eesraoncu/bitirme-ika-otonom/docs/Bitirme_Uygulama_Plani.docx

Bitirme Projesi Uygulama Planı

LLM Komutan, Gömülü Bekçi · Otonom İKA · Adım adım kurulum ve geliştirme

# 0. Bu Belge Nasıl Kullanılır

Belge baştan sona sırayla izlenmek için yazıldı. Her fazın sonunda yeşil bir “Bitti sayılır” kutusu var; o kutudaki koşul sağlanmadan bir sonraki faza geçme. Turuncu kutular sık yapılan hataları ve dikkat edilmesi gerekenleri gösterir. Gri zeminli satırlar terminale olduğu gibi yazılacak komutlardır.

Terminal, Ubuntu’da Ctrl + Alt + T ile açılır. Bir komutun başında sudo varsa sistem şifreni ister; yazarken ekranda karakter görünmez, bu normaldir.

Kod nerede yazılacak: Kodun tamamı Claude Code ile, kendi bilgisayarındaki proje klasöründe yazılır. Mimari kararlar, takıldığın yerler ve fazlar arası planlama için claude.ai sohbetini kullanmaya devam edebilirsin. Claude Code’un kurulumu Bölüm 3.10’da.

# 1. Sistemin Son Hâli

Kuracağın sistemde iki tür komut vardır ve ikisi de araca ulaşmadan önce STM32 kartından geçer:

- Görev komutu: LLM ajanının ürettiği üst seviye komut (“şu noktaya git”, “60 saniye bekle”, “hız sınırı 0,3 m/s”, “dur”). Kart onaylarsa Nav2’ye gider. Coğrafi sınır, tazelik, imza ve tutarlılık kuralları burada uygulanır.
- Hız komutu: Nav2’nin araca her saniye onlarca kez gönderdiği hareket komutu (cmd_vel: doğrusal ve açısal hız). Kart onaylarsa simülasyondaki İKA’ya gider. Fiziksel limitler ve kalp atışı kuralları burada uygulanır.

Bilgisayar ile kart arasında iki ayrı fiziksel hat vardır. Böylece ajan tarafı ile araç tarafı birbirine hiçbir yerde doğrudan dokunmaz:

Tablo 1. Fiziksel bağlantılar

Hat | Fiziksel bağlantı | Ne taşır
Ajan kanalı | PC USB → Nucleo’nun kendi USB portu (dahili sanal seri port) | PC’deki ajan ve Nav2’nin ürettiği komutlar karta gelir; ret gerekçeleri ajana döner.
CAN hattı | Kart üzerindeki FDCAN1 → CAN modülü → iki tel → CAN modülü → FDCAN2 | Onaylanan komutlar kartın “ajan tarafı” düğümünden “araç tarafı” düğümüne araç içi veri yolu gibi taşınır.
Araç kanalı | Kartın ikinci UART’ı → USB-TTL dönüştürücü → PC USB | Onaylı komutlar simülasyondaki İKA’ya gider; aracın telemetrisi (konum, hız) karta gelir.

Neden aynı kartta iki CAN düğümü? Gerçek bir araçta bekçi kartı ile motor sürücü kartı ayrı olur ve CAN ile konuşur. Elinde ikinci kart olmadığı için araç tarafındaki kartı, aynı Nucleo’nun ikinci CAN birimiyle taklit ediyorsun. Veri gerçekten tellerden geçtiği için CAN davranışı ve gecikmesi gerçektir. Bu kararı hocana da böyle anlatabilirsin.

# 2. Alışveriş Listesi

Parça | Adet | Not
STM32 NUCLEO-G474RE | 1 | Elinde var.
SN65HVD230 CAN alıcı-verici modülü | 2 | 3,3 V ile çalışan model olmalı. Üzerinde 120 Ω sonlandırma direnci (çoğunlukla “R2” ya da “120R” yazar) olup olmadığına bak; yoksa 2 adet 120 Ω direnç ekle.
USB-TTL dönüştürücü (CP2102 ya da CH340) | 1 | 3,3 V seviye seçilebilen bir model tercih et. Araç kanalı için.
Mantık analizörü (8 kanal, 24 MHz) | 1 | “Saleae uyumlu” diye satılır. Gecikme ölçümü ve hata ayıklama için. Önerilir.
Jumper kablo seti (erkek-dişi, dişi-dişi) | 1 set | Modülleri ve dönüştürücüyü karta bağlamak için.
Küçük breadboard | 1 | Modülleri sabitlemek için.
Veri destekli USB kablo | 2 | Biri Nucleo için (kartın portuna uyan tip), biri USB-TTL için gerekirse. Sadece şarj eden kablolar kartı tanımaz.

Robotistan, Direnc.net gibi elektronik mağazalarında hepsi bulunur. Tek siparişte almak kargo süresini kısaltır.

# 3. Kurulum (Faz 0 · Parçalar gelmeden yapılır)

Bu fazın amacı, kod yazmaya başlamadan önce her aracın çalıştığını tek tek doğrulamaktır. Her adımın sonunda bir doğrulama komutu var; onu çalıştırmadan sonraki adıma geçme.

Tablo 2. Kullanılacak yazılımlar

Yazılım | Ne işe yarar | Nereden
ROS 2 Humble | Robot yazılımının omurgası; tüm parçalar birbiriyle bunun üzerinden konuşur. | docs.ros.org/en/humble (Installation → Ubuntu deb packages)
Gazebo Fortress | İKA’nın ve ortamın simülasyonu. Humble’ın resmi eşi. | TurtleBot 4 kullanım kılavuzu ile birlikte kurulur
TurtleBot 4 simülatörü | Hazır İKA modeli: kamera (RGB-D), lidar ve sürüş sistemi hazır. | turtlebot.github.io/turtlebot4-user-manual
RTAB-Map | vSLAM: kamerayla haritayı çıkarır ve aracın konumunu bulur. | apt (ROS paketi)
Nav2 | Harita üzerinde rota planlar ve aracı hedefe sürer. | apt (ROS paketi)
STM32CubeIDE | STM32 kodu yazma, derleme, karta yükleme ve hata ayıklama. İçinde CubeMX (pin ve saat ayar aracı) da var. | st.com (ücretsiz myST hesabı ister)
PulseView | Mantık analizörünün bilgisayar programı. | apt
Ollama | LLM’i kendi bilgisayarında çalıştırmak için. | ollama.com
VS Code | Genel kod düzenleyici. | code.visualstudio.com
Git + GitHub | Sürüm kontrolü ve kodun yedeği. | apt + github.com
Claude Code | Kodun Claude ile birlikte yazılacağı ortam. | docs.claude.com/en/docs/claude-code/overview

## 3.1 Sistemi güncelle

ROS 2’nin resmi kurulum sayfası, Ubuntu 22.04’te ROS kurmadan önce sistemin güncellenmesini özellikle istiyor; aksi hâlde bazı kritik sistem paketleri silinebiliyor.

sudo apt update && sudo apt upgrade -y

Bittikten sonra bilgisayarı bir kez yeniden başlat.

## 3.2 Temel araçlar

sudo apt install -y git curl wget build-essential python3-pip python3-serial minicom

VS Code için code.visualstudio.com adresine git, “.deb” sürümünü indir, sonra indirilenler klasöründe şunu çalıştır (code_ ile başlayan dosya adını kendi dosyanla değiştir):

cd ~/İndirilenler # İngilizce sistemde: cd ~/Downloads

sudo apt install ./code_*.deb

Bitti sayılır: Terminalde git --version bir sürüm numarası yazıyor ve VS Code uygulama menüsünden açılıyor.

## 3.3 ROS 2 Humble

vSLAM çalışmasında ROS 2 kullandığın için kurulu olabilir. Önce kontrol et:

ls /opt/ros

Çıktıda humble görüyorsan bu adımın kurulum kısmını atla, sadece ortam ayarına ve teste bak. Görmüyorsan docs.ros.org/en/humble adresinde Installation → Ubuntu (deb packages) sayfasını aç ve oradaki “Setup Sources” bölümünü sayfadaki komutlarla harfi harfine uygula. Depo ekleme yöntemi zaman zaman değiştiği için bu kısmı buraya kopyalamadım; her zaman resmi sayfadaki güncel komutu kullan. Kaynak eklendikten sonra:

sudo apt update

sudo apt install -y ros-humble-desktop ros-dev-tools

Her yeni terminalde ROS’un otomatik tanınması için:

echo "source /opt/ros/humble/setup.bash" >> ~/.bashrc

source ~/.bashrc

Test: iki ayrı terminal aç. Birincisine konuşan, ikincisine dinleyen düğümü yaz:

ros2 run demo_nodes_cpp talker # 1. terminal

ros2 run demo_nodes_py listener # 2. terminal

Bitti sayılır: İkinci terminalde “I heard: Hello World” satırları akıyor. Durdurmak için Ctrl + C.

## 3.4 Gazebo Fortress ve TurtleBot 4 simülatörü

turtlebot.github.io/turtlebot4-user-manual adresinde Software → TurtleBot 4 Simulator sayfasını aç ve “humble” sekmesini seç. Kılavuz önce Ignition Fortress’in kurulmasını, ardından simülatör paketlerini istiyor. Fortress’i kılavuzdaki komutlarla kurduktan sonra:

sudo apt install -y ros-humble-turtlebot4-simulator ros-humble-irobot-create-nodes

Test:

ros2 launch turtlebot4_ignition_bringup turtlebot4_ignition.launch.py

Dikkat: İlk açılış, dünya modelleri internetten indirildiği için uzun sürebilir. Gazebo penceresi siyah kalırsa bu, bu simülatörde bilinen bir sorundur ve genellikle dünya dosyasının indirilememesinden kaynaklanır. Önce birkaç dakika bekle; düzelmezse sohbete gel, internet gerektirmeyen yerel bir dünya ayarlarız.

Bitti sayılır: Gazebo penceresinde TurtleBot 4 görünüyor ve başka bir terminalde ros2 topic list komutu kamera ve lidar konularını listeliyor.

## 3.5 RTAB-Map ve Nav2

sudo apt install -y ros-humble-rtabmap-ros ros-humble-navigation2 ros-humble-nav2-bringup ros-humble-teleop-twist-keyboard

Bitti sayılır: ros2 pkg list | grep -E "rtabmap|nav2" komutu paket isimlerini listeliyor.

## 3.6 STM32CubeIDE

1. st.com adresine git, arama kutusuna “STM32CubeIDE” yaz ve ürün sayfasını aç.
2. “Get Software” bölümünden “STM32CubeIDE Debian Linux Installer” satırındaki indirme düğmesine bas.
3. Sitede hesabın yoksa ücretsiz myST hesabı aç; e-postana gelen bağlantıdan indirmeyi tamamla.
4. İnen zip dosyasını indirilenler klasöründe aç (unzip dosya_adi.zip).
5. İçinden çıkan “.sh” uzantılı kurulum dosyasını çalıştır: chmod +x st-stm32cubeide_*.sh && sudo ./st-stm32cubeide_*.sh. Lisans sorularını kabul et; ST-LINK sürücülerinin (udev kuralları) kurulmasını da onayla.
6. Seri portlara şifresiz erişebilmek için kullanıcını dialout grubuna ekle: sudo usermod -aG dialout $USER. Bu ayar ancak oturumu kapatıp açınca geçerli olur.

Test (kartın çalıştığını görmek için LED yakıp söndürmek):

1. CubeIDE’yi aç, çalışma klasörü (workspace) olarak ev dizininde yeni bir klasör seç.
2. File → New → STM32 Project. “Board Selector” sekmesinde NUCLEO-G474RE’yi ara ve seç. Proje adına “deneme_led” yaz.
3. “Initialize all peripherals with their default Mode?” sorusuna Yes de. Kartın varsayılan ayarları gelir; LD2 adlı yeşil LED zaten tanımlı olur.
4. main.c içinde while (1) döngüsüne şu iki satırı ekle: HAL_GPIO_TogglePin(LD2_GPIO_Port, LD2_Pin); ve HAL_Delay(500);
5. Kartı USB ile bağla, üstteki yeşil ok (Run) düğmesine bas. İlk seferde ST-LINK yazılımını güncellemeyi önerebilir; kabul et.

Bitti sayılır: Karttaki yeşil LED saniyede bir yanıp sönüyor.

## 3.7 Seri port ve mantık analizörü araçları

sudo apt install -y pulseview sigrok-firmware-fx2lafw

Kartın seri portunu bulmak için kartı tak ve ls /dev/ttyACM* yaz; genellikle /dev/ttyACM0 çıkar. USB-TTL dönüştürücü ise /dev/ttyUSB0 olarak görünür.

## 3.8 Ollama (yerel LLM)

curl -fsSL https://ollama.com/install.sh | sh

nvidia-smi # ekran kartını ve belleğini gösterir

nvidia-smi bir tablo gösteriyorsa NVIDIA ekran kartın var demektir; tablodaki bellek miktarı hangi boyutta model çalıştırabileceğini belirler. Komut bulunamazsa ekran kartı yoktur ya da sürücüsü kurulu değildir. Hangi modeli kullanacağına Faz 4’te, bu bilgiye ve o günkü güncel seçeneklere göre birlikte karar vereceğiz; araç çağırmayı (tool calling) desteklemesi şart. Bilgisayar yetersiz kalırsa bir API kullanmak da mümkün.

## 3.9 Git ve GitHub

git config --global user.name "Esra Öncü"

git config --global user.email "github_e-postan"

github.com’da “bitirme-ika-bekci” adında özel (private) bir depo oluştur. Depoyu bilgisayarına Bölüm 4’teki klasör yapısını kurarken bağlayacağız.

## 3.10 Claude Code

Kurulum yöntemi zaman zaman güncellendiği için docs.claude.com/en/docs/claude-code/overview sayfasındaki güncel kurulum adımlarını izle ya da claude.ai/download adresinden masaüstü uygulamasını indir. Kurulumdan sonra proje klasöründe başlatıp claude.ai hesabınla giriş yapman yeterli.

Bitti sayılır: Bölüm 3’teki tüm yeşil kutular sağlandı. Bu noktada bilgisayarın projeye hazır.

# 4. Proje Klasör Yapısı

Temel kural: her sorumluluk kendi klasöründe durur ve bir kavram tek bir yerde gerçeklenir. Bir kuralı değiştirmek istediğinde tek bir klasöre bakman yeterli olmalı. Bir değişiklik birden fazla klasöre dokunmayı gerektiriyorsa tasarım yanlıştır.

bitirme-ika-bekci/

├── docs/ STATUS, DECISIONS, RULES, protocol

├── shared/protocol/ messages.yaml (mesajların TEK tanımı)

├── firmware/ STM32CubeIDE projesi

│ └── app/

│ ├── protocol/ çerçeve çözme, CRC

│ ├── auth/ HMAC imza, tekrar kontrolü

│ ├── rules/

│ │ ├── geofence/ coğrafi sınır

│ │ ├── limits/ hız, ivme, dönüş

│ │ ├── freshness/ zaman damgası

│ │ ├── heartbeat/ kalp atışı

│ │ └── consistency/ konum tutarlılığı

│ ├── recovery/ kurtarma eylemi seçimi

│ ├── links/ ajan UART, araç UART, CAN

│ └── timing/ ölçüm pini, çevrim sayacı

├── ros2_ws/src/

│ ├── ika_sim/ dünya, başlatma dosyaları

│ ├── ika_nav/ RTAB-Map, Nav2, yasak bölge

│ ├── guard_bridge/ ROS 2 ↔ kart köprüsü

│ ├── llm_agent/ ajan, araçlar, yer adları

│ └── experiments/ senaryolar, kayıt

└── analysis/ sonuç betikleri, grafikler

Tek kaynak ilkesi: Mesaj formatı hem kartta (C) hem bilgisayarda (Python) kullanılır. İki tarafta ayrı ayrı elle yazılırsa bir gün birbirinden kayar ve en zor bulunan hatalar buradan çıkar. Bu yüzden mesajlar yalnızca shared/protocol/messages.yaml içinde tanımlanır, iki taraftaki kod bu dosyadan otomatik üretilir.

Proje hafızası: docs/STATUS.md her çalışma oturumunun başında okunur, sonunda güncellenir (ne yapıldı, ne kaldı, nerede takıldın). Kalıcı kararlar docs/DECISIONS.md dosyasına yalnızca eklenerek yazılır; eski kararlar silinmez. Claude Code’a her oturumda önce bu iki dosyayı okutmak, bağlamı her seferinde yeniden anlatma zahmetinden kurtarır.

# 5. Geliştirme Fazları

Takvim, hocaya sunduğun belgedeki 14 haftalık planla aynıdır.

## Faz 1 · Hafta 1–2 · Literatür, kurallar, mesaj formatı

### Okuma listesi

- Sha, L. (2001). Using simplicity to control complexity. IEEE Software. (Simplex mimarisinin temeli)
- Bak, S. ve diğ. (2009). The System-Level Simplex Architecture for Improved Real-Time Embedded System Safety. (Denetleyiciyi ayrı donanıma taşıma)
- Runtime Verification in Real-Time with the Copilot Language: A Tutorial. (NASA’nın gömülü izleyicileri)
- ASTM F3269: Run-time assurance standardı. (Özetini okumak yeterli)
- arXiv 2601.15486: LLM-Agnostic, MAVLink-Based Drone Command and Control Interface… (LLM ile araç yönetiminde komut doğrulama)
- Synergistic Simplex: Cooperative Runtime Assurance (2026 ön baskı). (Kapalı döngüye en yakın çalışma)

### Yapılacaklar

1. Her kural için eşik değerlerini belirle ve docs/RULES.md’ye yaz: izinli bölge, azami doğrusal hız, azami açısal hız, azami ivme, komutun en fazla kaç milisaniye eski olabileceği, kalp atışı zaman aşımı, konum tutarlılığı toleransı.
2. Kurtarma eylemlerini ve hangi durumda hangisinin seçileceğini tabloya dök.
3. Mesaj çerçevesini tasarla: başlangıç baytı, mesaj tipi, sayaç, zaman damgası, yük, HMAC etiketi, CRC. docs/protocol.md’ye açıkla, shared/protocol/messages.yaml’a yaz.
4. Ret gerekçesi mesajının biçimini belirle: hangi kural, neden, izinli değer aralığı.

Bitti sayılır: docs/RULES.md ve docs/protocol.md tamam; messages.yaml’dan C başlık dosyası ve Python modülü üretilebiliyor.

## Faz 2 · Hafta 3–5 · STM32 tarafı

### 2.1 Proje ve saat ayarı

Yeni bir STM32 projesi aç (Bölüm 3.6’daki gibi). CubeMX ekranında Clock Configuration sekmesinden sistem saatini 170 MHz’e ayarla; G474’ün azami hızı budur. Kodun tamamını firmware/app/ altındaki klasörlerde yaz; CubeMX’in ürettiği dosyalara yalnızca bu klasörlerdeki fonksiyonları çağıran birkaç satır eklenir. Böylece CubeMX ayarı yeniden üretildiğinde kodun silinmez.

### 2.2 Ajan kanalı: bilgisayarla konuşma

Nucleo’nun USB portu aynı zamanda bir seri port gibi görünür. Kartın bu porta bağlı UART birimi CubeMX’te önceden tanımlıdır (Pinout görünümünde “VCP” etiketli pinlere bak). Hızı 115200 baud yap ve bilgisayardan gelen her baytı geri yollayan bir yankı (echo) programı yaz. Test:

minicom -D /dev/ttyACM0 -b 115200

Yazdığın harfler ekrana geri geliyorsa kanal çalışıyor. Minicom’dan çıkmak için Ctrl + A, ardından X.

### 2.3 CAN: modüller gelmeden iç döngü testi

FDCAN birimi “internal loopback” modunda kendi gönderdiği mesajı dışarı çıkarmadan kendisi alır. Modüller gelmeden CAN yazılımını bu modda geliştir: FDCAN1’i klasik CAN, 500 kbit/s olarak ayarla, bir mesaj gönder, alındığında LED’i yak.

### 2.4 CAN: modüllerle gerçek hat

CubeMX’te FDCAN1 ve FDCAN2’yi etkinleştir ve her biri için Pinout görünümünün önerdiği TX/RX pinlerini not al. Nucleo’nun üzerindeki bağlantı başlıklarında bu pinlerin yerini kartın kullanım kılavuzundan (UM2505) ya da CubeMX’in pin görünümünden bul. Kablolama:

Tablo 3. CAN kablolaması (her iki modül için aynı)

Modül pini | Bağlanacağı yer | Açıklama
3V3 | Nucleo 3V3 | Modülün beslemesi. Asla 5 V’a bağlama.
GND | Nucleo GND | Ortak toprak şart.
CTX (ya da TX) | FDCANx_TX pini | Karttan hatta giden veri.
CRX (ya da RX) | FDCANx_RX pini | Hattan karta gelen veri.
CANH | Diğer modülün CANH’ı | İki modül arasındaki tel. Telleri birbirine burarsan gürültü azalır.
CANL | Diğer modülün CANL’ı | İkinci tel.

Sonlandırma: CAN hattının iki ucunda da 120 Ω direnç olmalı. Modüllerin üzerinde varsa ek bir şey yapma. İkisinde de yoksa CANH ile CANL arasına her uçta birer 120 Ω direnç tak. Bu dirençler olmazsa hat çoğu zaman hiç çalışmaz ve hata ayıklamak çok zaman alır.

Test: FDCAN1’den gönderilen mesaj FDCAN2’de alınsın ve alınan mesaj ajan kanalından bilgisayara yazdırılsın.

### 2.5 Araç kanalı: USB-TTL dönüştürücü

CubeMX’te kullanılmayan bir USART birimini etkinleştir (ör. USART1 ya da USART3), 115200 baud yap. Dönüştürücüyü 3,3 V seviyesine ayarla. Bağlantı çapraz yapılır: dönüştürücünün TX’i kartın RX’ine, dönüştürücünün RX’i kartın TX’ine, GND GND’ye. Dönüştürücünün 5V ya da 3V3 besleme pinini karta bağlama; kart zaten USB’den besleniyor.

minicom -D /dev/ttyUSB0 -b 115200

### 2.6 Protokol, ilk kurallar ve zaman ölçümü

1. firmware/app/protocol/: çerçeve çözme ve CRC. Bozuk çerçeve sessizce atılmaz, sayılır ve raporlanır.
2. firmware/app/rules/geofence/: izinli bölge çokgeni ve “nokta çokgenin içinde mi” testi.
3. firmware/app/rules/heartbeat/: bir donanım zamanlayıcısı; ajan kanalından belirli süre sinyal gelmezse kurtarma modülünü tetikler.
4. firmware/app/timing/: boş bir pini karar başında 1, sonunda 0 yap; ayrıca işlemcinin çevrim sayacıyla (DWT) süreyi ölç. Mantık analizörünü bu pine bağlayıp PulseView’de süreyi gör.

Bitti sayılır: Bilgisayardan elle gönderilen bir hedef noktası, izinli bölgedeyse CAN üzerinden geçip araç kanalından çıkıyor, dışındaysa ret gerekçesiyle ajan kanalına dönüyor. USB kablosu çekildiğinde kalp atışı kuralı devreye giriyor. Karar süresi PulseView’de ölçülebiliyor.

## Faz 3 · Hafta 6–8 · Simülasyon, haritalama, navigasyon, köprü

### 3.1 Harita çıkarma (RTAB-Map)

1. Simülasyonu başlat (Bölüm 3.4’teki komut).
2. Kameranın konu isimlerini öğren: ros2 topic list | grep -i oakd. Renkli görüntü, derinlik görüntüsü ve kamera bilgisi konularını not al.
3. RTAB-Map’i bu konu isimleriyle RGB-D modunda başlat. vSLAM çalışmasındaki başlatma dosyan varsa oradan başla; yalnızca konu isimlerini değiştirmen yeterli olabilir.
4. Aracı klavyeyle gezdir: ros2 run teleop_twist_keyboard teleop_twist_keyboard. Ortamın her köşesini en az bir kez gör; aynı yerlerden tekrar geçmek haritayı düzeltir (döngü kapatma).
5. Nav2’nin kullanacağı iki boyutlu haritayı kaydet: ros2 run nav2_map_server map_saver_cli -f ~/harita.

### 3.2 Navigasyon (Nav2)

Nav2’yi kaydettiğin haritayla başlat. RViz’de “2D Goal Pose” düğmesiyle haritada bir hedef tıkla; araç oraya gitmeli. Ardından deneydeki B yapılandırması için Nav2’nin yasak bölge filtresini (keepout filter) kur: haritanın bir kopyasında yasak alanları siyaha boyayıp maske olarak ver.

### 3.3 Köprü (guard_bridge)

Bu adımda sistemin omurgası birleşir. Nav2’nin hız komutu çıkışını doğrudan araca değil, köprüye yönlendir (konu adını yeniden eşleyerek). Köprü şunları yapar:

- Görev komutlarını ve Nav2’nin hız komutlarını shared/protocol’deki biçimde paketleyip ajan kanalından karta yollar.
- Araç kanalından gelen onaylı komutları simülasyondaki İKA’ya (hız) ya da Nav2’ye (hedef) iletir.
- Aracın konum ve hız bilgisini araç kanalından karta yollar.
- Karttan gelen ret gerekçelerini ajanın okuyacağı bir konuya yayınlar.

Bitti sayılır: RViz’den verilen hedef kart üzerinden geçerek araca ulaşıyor; izinli bölge dışındaki hedef reddediliyor; kartın kablosu çekilince araç duruyor.

## Faz 4 · Hafta 9–10 · LLM ajanı ve kalan kurallar

1. Model seçimi (Bölüm 3.8’deki ekran kartı bilgisine göre birlikte). Deney tekrarlanabilir olsun diye sıcaklık (temperature) değeri sabitlenir ve kaydedilir.
2. llm_agent/places.yaml: haritadaki yerlere isim ver (“depo arkası”, “kapı önü”, “şarj istasyonu”) ve koordinatlarını RViz’den okuyarak yaz. LLM koordinat uydurmak yerine bu isimleri kullanır; uydurursa bekçi yakalar.
3. Ajanın araçlarını tanımla: git(yer ya da koordinat), bekle(süre), hız_sınırı(değer), dur().
4. Ret gerekçesi döngüsü: gerekçe ajana yeni bir mesaj olarak verilir, ajan planını düzeltip yeni komut üretir. Deneme sayısına üst sınır koy.
5. Kalan kurallar: tazelik, HMAC ve sayaç kontrolü, konum tutarlılığı, fiziksel limitler. HMAC anahtarı hem kartta hem bilgisayarda aynı olur ama depoya asla girmez (.gitignore’daki ayrı bir dosyada durur).
6. Kurtarma davranışı: yerinde bekle, hızı düşürüp devam et, en yakın güvenli noktaya git, başlangıca dön.

Bitti sayılır: Doğal dille verilen bir görev (“depo arkasına git, orada 30 saniye bekle”) baştan sona kart üzerinden çalışıyor; hatalı bir komut reddedildiğinde ajan gerekçeyi kullanarak kendini düzeltiyor.

## Faz 5 · Hafta 11–12 · Deneyler

1. experiments/scenarios.yaml: normal görevler, belirsiz talimatlar, sınırları zorlayan talimatlar, görev metnine gizlenmiş kötü niyetli talimatlar, ajanın donması, bağlantı kopması.
2. Dört yapılandırma (A: bekçi yok, B: yalnız Nav2 korumaları, C: bekçi var ama gerekçesiz ret, D: bekçi ve gerekçeli ret) tek bir başlatma parametresiyle seçilebilsin.
3. LLM her seferinde farklı cevap verebildiği için her senaryo her yapılandırmada çok kez koşulur (ör. 20 tekrar). Kesin tekrar sayısı Faz 1’de hocanla netleştirilir.
4. Her koşu otomatik kaydedilir (CSV): komut, kararın sonucu, gerekçe, süreler, görev sonucu.
5. Kart üzerindeki karar süreleri mantık analizörüyle ayrıca ölçülür.

Bitti sayılır: Tüm senaryolar dört yapılandırmada koşuldu, sonuçlar analysis/ klasöründeki betikle tablolara ve grafiklere dönüştü.

## Faz 6 · Hafta 13–14 · Analiz, tez, demo

- Sonuç bölümü araştırma sorularına (S1–S3) birebir cevap verecek şekilde yazılır.
- Demo: doğal dil görevi, sahte komutun reddedilmesi, kablo çekilince güvenli moda geçiş, gerekçeyle kendini düzelten ajan.
- Demo gününde bir şey ters giderse diye demonun tamamı önceden videoya kaydedilir.

# 6. Çalışma Düzeni

- Her oturum docs/STATUS.md okunarak başlar, güncellenerek biter.
- Kod küçük adımlarla ve anlamlı mesajlarla GitHub’a yüklenir (commit); çalışan her ara durum kaydedilir.
- Hocana haftada bir kısa rapor: bu hafta ne bitti, gelecek hafta ne yapılacak, nerede yardıma ihtiyaç var.
- Kapsam kuralı: yeni bir özellik ancak sonuç tablosuna yeni bir satır ekliyorsa eklenir.

# 7. Olası Sorunlar ve B Planları

Sorun | B planı
CAN modülleri geç geldi | Faz 2’ye iç döngü (loopback) moduyla devam et; gerçek hat testi modüller gelince yapılır.
CAN hattı hiç çalışmıyor | Önce sonlandırma dirençlerini, sonra TX/RX’in ters bağlanıp bağlanmadığını, sonra iki tarafın bit hızının aynı olduğunu kontrol et. Mantık analizörüyle hattı izle.
Gazebo siyah ekran | İnternet gerektirmeyen yerel bir dünya dosyası kullan.
Bilgisayar LLM için yetersiz | Daha küçük bir model ya da bir API kullan; seçilen model ve ayarları tezde açıkça belirt.
RTAB-Map yavaş | Kamera görüntü hızını ve çözünürlüğünü düşür; haritayı bir kez çıkarıp sonrasında yalnızca konumlandırma modunda çalıştır.
Takvim kayıyor | Önce tutarlılık kuralını, sonra kurtarma eylemlerinin sayısını azalt. Araştırma sorularının üçü de korunur.
