eesraoncu/bitirme-ika-otonom/ros2_ws/src/ika_sim/worlds/textures/asfalt.jpg

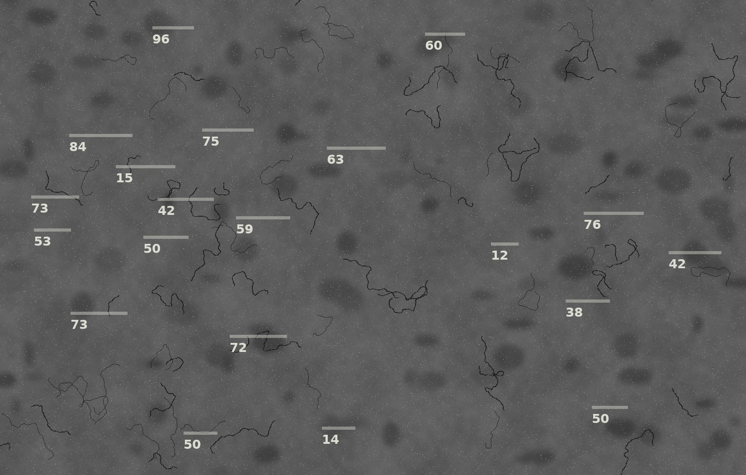
ros2_ws/src/ika_sim/worlds/textures/asfalt.jpg
