eesraoncu/bitirme-ika-otonom/ros2_ws/src/ika_sim/worlds/textures/yasak.jpg

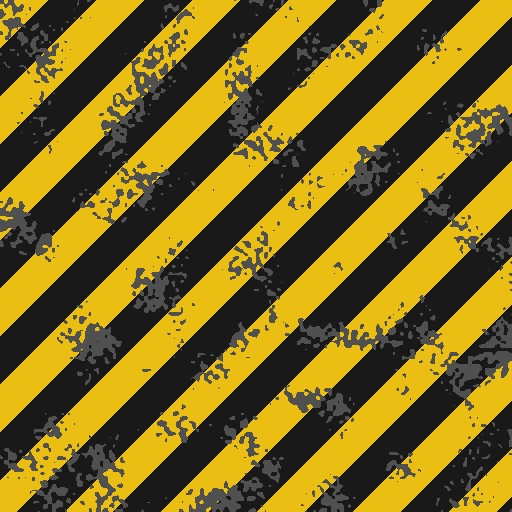
ros2_ws/src/ika_sim/worlds/textures/yasak.jpg
