eesraoncu/bitirme-ika-otonom/ros2_ws/src/ika_sim/models/ika_arac/meshes/MRB.STL

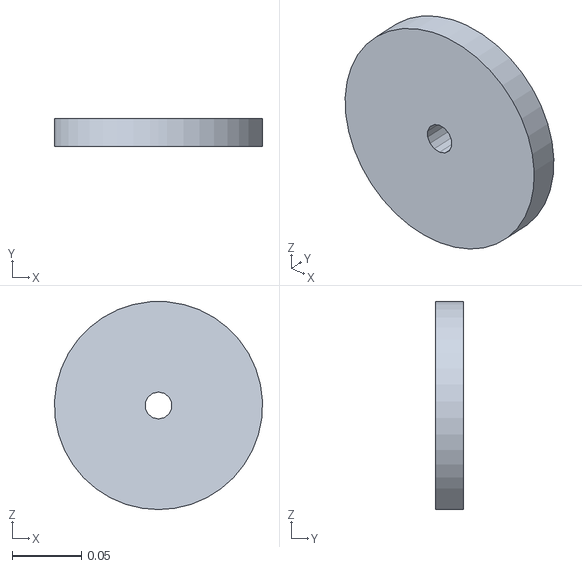
[picture p9: CAD file, 2026-10-06]
ros2_ws/src/ika_sim/models/ika_arac/meshes/MRB.STL
0.15 x 0.02 x 0.15
