eesraoncu/bitirme-ika-otonom/ros2_ws/src/ika_sim/models/ika_arac/meshes/BL_salıncak.STL

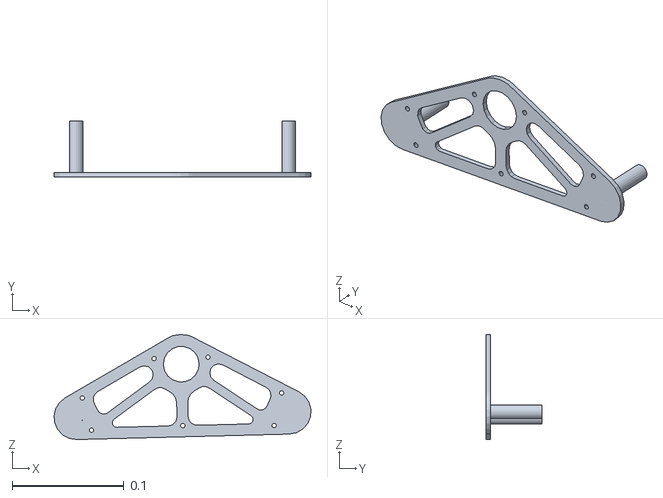
[picture p10: CAD file, 2026-10-06]
ros2_ws/src/ika_sim/models/ika_arac/meshes/BL_salıncak.STL
0.23 x 0.05 x 0.0939
