eesraoncu/bitirme-ika-otonom/ros2_ws/src/ika_sim/models/ika_arac/meshes/KULE_UST.STL

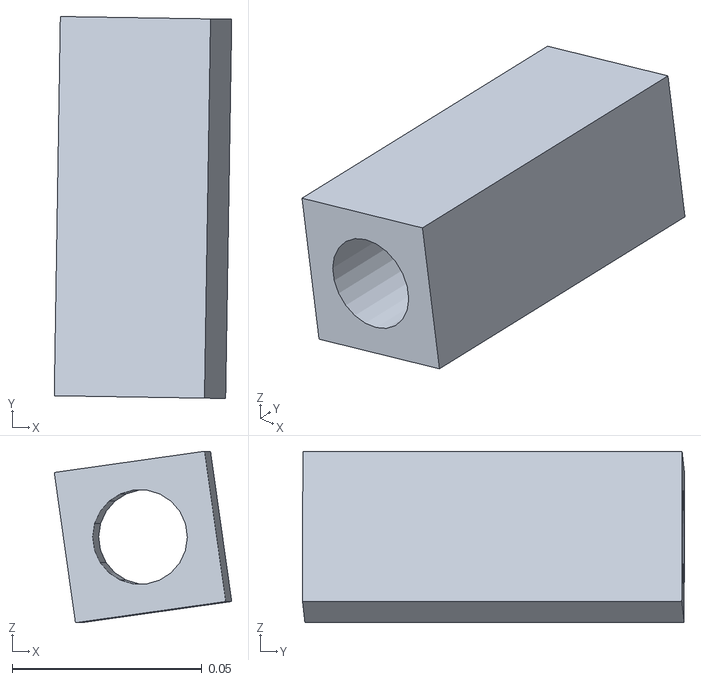
[picture p11: CAD file, 2026-10-06]
ros2_ws/src/ika_sim/models/ika_arac/meshes/KULE_UST.STL
0.0468 x 0.101 x 0.0452
