eesraoncu/bitirme-ika-otonom/ros2_ws/src/ika_sim/models/ika_arac/meshes/base_link.STL

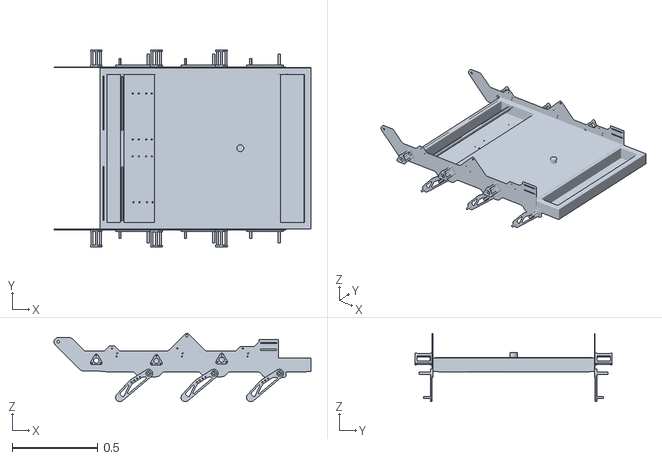
[picture p12: CAD file, 2026-10-06]
ros2_ws/src/ika_sim/models/ika_arac/meshes/base_link.STL
1.51 x 1.16 x 0.403
