eesraoncu/bitirme-ika-otonom/ros2_ws/src/ika_sim/models/ika_arac/meshes/FL_salıncak.STL

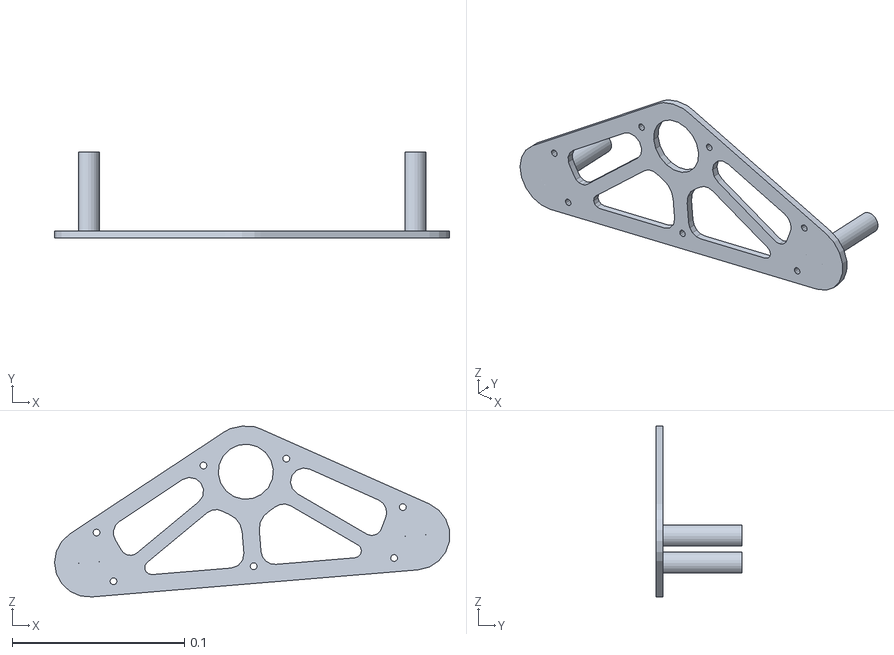
[picture p13: CAD file, 2026-10-06]
ros2_ws/src/ika_sim/models/ika_arac/meshes/FL_salıncak.STL
0.229 x 0.05 x 0.0991
