eesraoncu/bitirme-ika-otonom/ros2_ws/src/ika_sim/models/ika_arac/meshes/KULE_ALT.STL

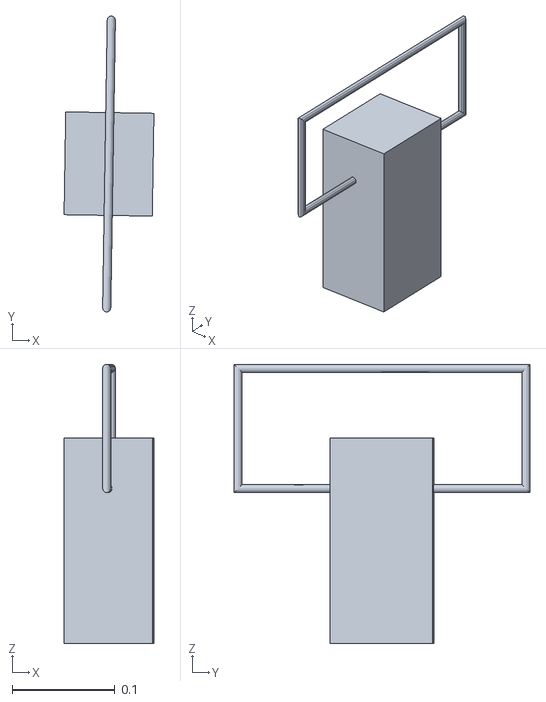
[picture p15: CAD file, 2026-10-06]
ros2_ws/src/ika_sim/models/ika_arac/meshes/KULE_ALT.STL
0.0874 x 0.288 x 0.272
