eesraoncu/bitirme-ika-otonom/ros2_ws/src/ika_sim/models/ika_arac/meshes/FR_salıncak.STL

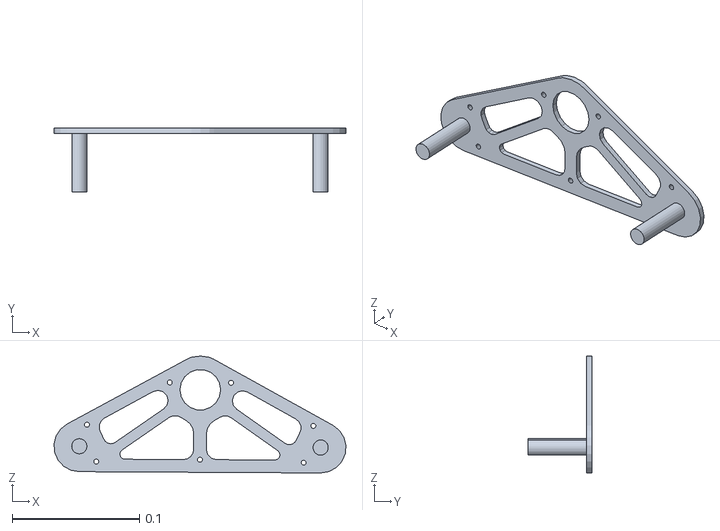
[picture p16: CAD file, 2026-10-06]
ros2_ws/src/ika_sim/models/ika_arac/meshes/FR_salıncak.STL
0.23 x 0.05 x 0.092
