eesraoncu/bitirme-ika-otonom/(list of files, cad)

Other CAD files:
ros2_ws/src/ika_sim/models/ika_arac/meshes/FLB.STL
ros2_ws/src/ika_sim/models/ika_arac/meshes/MLB.STL
ros2_ws/src/ika_sim/models/ika_arac/meshes/BLB.STL
ros2_ws/src/ika_sim/models/ika_arac/meshes/BLF.STL
ros2_ws/src/ika_sim/models/ika_arac/meshes/FLF.STL
ros2_ws/src/ika_sim/models/ika_arac/meshes/FRF.STL
ros2_ws/src/ika_sim/models/ika_arac/meshes/BRB.STL
ros2_ws/src/ika_sim/models/ika_arac/meshes/MR_salıncak.STL
ros2_ws/src/ika_sim/models/ika_arac/meshes/FRB.STL
ros2_ws/src/ika_sim/models/ika_arac/meshes/MLF.STL
ros2_ws/src/ika_sim/models/ika_arac/meshes/MRF.STL
ros2_ws/src/ika_sim/models/ika_arac/meshes/BRF.STL
