eesraoncu/bitirme-ika-otonom/(commit log)

2026-09-22 Faz 0 tamamlandı: kurulumlar ve proje adı güncellendi
    - STM32CubeIDE 2.2.0, RTAB-Map, minicom, pulseview kuruldu
    - dialout grubu üyeliği eklendi (oturum kapatma bekliyor)
    - Proje adı bitirme-ika-otonom olarak güncellendi
    - STATUS: disk darlığı ve LED testinin yapılmadığı kayda geçti
2026-09-22 Kart kimliği doğrulandı, veri kablosu listeye eklendi
    NUCLEO-G474RE MB1367/C, CN1 konektörü micro-USB (mini değil).
    Eldeki JBL hoparlör kablosunda veri teli yok: karta besleme gidiyor
    (LD3 yanıyor) ama lsusb'de ST cihazı görünmüyor.
    LED testi (plan 3.6) ve Faz 2'nin tamamı bu kabloya bağlı; siparişin
    en öncelikli kalemi. İlk sipariş ~532 TL.
2026-09-22 Malzeme listesi kesinleşti: Robiz.net'ten tek sipariş, 656,16 TL
    Tüm parçalar tek satıcıda stokta bulundu; üç kargo yerine bir kargo.
    Seçim gerekçeleri dosyaya yazıldı:
    - CP2102 tercih edildi (CH340G değil): CP2102 yapısal olarak 3,3 V'luk bir çip,
    TXD her zaman 3,3 V. CH340G'de jumper'ın çipi mi yoksa yalnızca VCC pinini mi
    beslediği belirsiz; yanlış tasarımda TXD'den 5 V çıkar.
    - MB-102 ayrı alındı, breadboard seti değil: setteki güç kaynağı modülü gereksiz
    (Nucleo'nun 3V3 pini besleyecek), ayrı alım 56 TL ucuz.
    - Micro-USB kablo veri desteği doğrulandı (480 Mb/s, 5 pin).
    120 Ω direnç siparişe girmedi: modüllerde hazır gelme ihtimali yük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
2026-09-24 Faz 1: RULES.md, kurtarma politikası ve eşik değerleri
    docs/RULES.md eklendi:
    - Katmanlı hız limitleri: Nav2 (0,26) < bekçi (0,30) < platform (0,46)
    - Tüm kuralların eşikleri, uygulandığı komut tipi ve gerekçe içeriği
    - Görev komutunda limit aşımı ret, hız komutunda kırpma
    - İvme, bölmesiz ve titremeye dayanıklı biçimde komut başına Δv ile denetleniyor
    - Tutarlılık toleransı fiziksel üst sınırdan türetildi: d0 + v_max·Δt
    - Sabit denetim sırası; durumu yalnızca imzası doğrulanmış mesajlar değiştirir
    - Kurtarma durum makinesi NORMAL/RECOVERY/HOLD, açılışta HOLD
    Kararlar:
    - K-010: kart kör sürmez; Nav2 yalnızca ajan kanalı canlıyken kulla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
2026-09-24 Faz 1 tamamlandı: protokol, kod üreticisi ve testler
    Planın Faz 1 koşulu sağlandı: RULES.md ve protocol.md tamam, messages.yaml'dan
    C başlığı ve Python modülü üretilebiliyor.
    Protokol (docs/protocol.md, K-014):
    - Çerçeve: COBS(başlık ‖ yük ‖ 8 baytlık HMAC etiketi ‖ CRC-16) ‖ 0x00
    - Hatta yalnızca tamsayı; kayan nokta yok (NaN limit denetimini atlatırdı)
    - Oturum kimliği imzaya girer: kart yeniden başlayınca eski çerçeveler düşer
    - Zaman eşitleme her kalp atışında (NTP benzeri, hata ≤ RTT/2)
    - Şema özeti HELLO'da: kart ile köprü farklı YAML'dan derlenmişse yakalanır
    - Porta göre güven: TELEMETRY yalnızca araç kanalından kabul edilir
    -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
2026-09-24 Faz 2.1: CubeMX'in ürettiği proje (dokunulmamış hâl)
    - NUCLEO-G474RE, STM32CubeMX 6.18.1, STM32CubeIDE projesi
    - Saat: HSE 24 MHz → PLL (/6 ×85 /2) → 170 MHz, boost kipi, 4 bekleme çevrimi
    - Açık birimler: GPIO, BSP LED/düğme, COM1 (LPUART1, 115200 8N1)
    - Terminalden derlendi: 26 dosya, 0 uyarı, flash 10 560 B
    Bu commit yalnızca CubeMX çıktısıdır. Bizim kodumuz sonraki commit'lerde.
2026-09-26 Faz 2.2 hazırlığı: K-017 ve çalışma kuralı
    - CLAUDE.md: önce anlat, onay al, sonra yaz
    - STATUS: FDCAN gönderme tamponu kuyruk modunda olmalı (Faz 2.3)
    - K-017: ajan kanalı CubeMX'te LPUART1, alma DMA ile
2026-09-27 Faz 2.2: LPUART1 CubeMX'te çevre birimi, alma ve gönderme DMA ile
    - BSP'nin VCP bileşeni kapatıldı (K-017)
    - LPUART1: 115200 8N1, PA2/PA3
    - DMA1 kanal 1: alma, dairesel. DMA1 kanal 2: gönderme, normal
    - LPUART1 kesmesi açık (hat hataları ve gönderim sonu için)
    - CubeMX'in ürettiği hâl, elle değişiklik yok
2026-09-27 Faz 2.2: ajan kanalı modülü ve yankı testi
    - app/links/agent_link: alma dairesel DMA, gönderme normal DMA ile.
    Hat hatasında HAL almayı durdurduğu için alma yeniden başlatılır
    - app.c: gelen baytları geri gönderen geçici yankı döngüsü
    - tools/echo_test.py: 100 KB rastgele veriyle yük testi, akış denetimli
    - Kartta doğrulandı: 102400/102400 bayt, 0 fark, 11422 B/s
2026-09-27 Belgeler: Faz 2.2 kapanışı ve K-018
    - STATUS: Faz 2.2 tamam, yankı ve yük testi sonuçları, CubeMX'in
    yeniden üretiminden öğrenilenler, derleme çalışma alanı notu
    - K-018: ajan kanalında gönderme de DMA ile
2026-09-30 Faz 2.5: USART1 ve DMA CubeMX'te
    Araç kanalı: USART1, PC4/PC5 (kartta D1/D0), 115200 8N1. Alma DMA1
    kanal 3 dairesel, gönderme kanal 4 normal, USART1 kesmesi açık.
    LPUART1 ile aynı düzen (K-017, K-018).
2026-09-30 Faz 2.5: seri hat hataları türüne göre sayılıyor
    serial_link, almayı yeniden başlatmadan önce HAL'in ErrorCode alanını
    okuyup hatayı türüne göre sayıyor: çerçeve (FE), gürültü (NE),
    taşma (ORE), diğer. rx_start() bu alanı sıfırladığı için sıra önemli.
    Kartta: araç kanalına 9600 baud'da 5 × 0x00 gönderildi, restarts = 5,
    frame = 5, diğerleri 0. Ardından 115200'de yankı çalıştı.
    [serial_link.c]
2026-09-30 Faz 2.6: CRC-16 ve COBS, C'de
    firmware/app/protocol/ altında crc16 ve cobs. frame.py'nin C karşılığı.
    Testler (shared/protocol/tests/test_c_framer.py) kart kodunu gcc ile
    derleyip Python referansıyla karşılaştırıyor: test_vectors.json, bozuk
    COBS, çıkış tamponu sınırı, rastgele veri. 101 test geçiyor.
2026-09-30 Faz 2.6: SHA-256 ve HMAC-SHA256, C'de
    firmware/app/auth/ altında sha256 (FIPS 180-4) ve hmac_sha256 (RFC 2104),
    etiket için sabit zamanlı karşılaştırma. Dışarıdan kod alınmadı.
    Testler: NIST girdileri, 0–130 bayt her uzunluk, RFC 4231'in 7 örneği,
    protocol.md §4.4'teki etiket, rastgele bölmelerle hashlib/hmac'e karşı.
    119 test geçiyor.
2026-09-30 Faz 2.6: çerçeve kodlama, çözme ve akış bölme, C'de
    firmware/app/protocol/frame: frame_encode, frame_decode (COBS → CRC →
    tip/yön/kanal/uzunluk → etiket), frame_rx. Mesaj bilgileri üretilmiş
    tablodan (proto_msg_info). Çözme tamponu hattın sınırında (64): Python'la
    her girdi aynı türe düşer.
    Testler: 17 çerçeve bayt bayt, 7 bozuk çerçeve, 1 500 rastgele bozulmuş
    çerçeve ve 100 akışta Python'la aynı karar. 147 test geçiyor.
2026-10-01 Belgeler: protocol.md'de HMAC maliyeti ölçülen değerle
2026-10-01 CubeMX: RNG açık, CK48 saati HSI48
    Oturum kimliği için donanım rastgele sayı üreteci (docs/protocol.md §5.2).
    RNG tam 48 MHz istiyor. PLLQ 340 MHz'den 48'i üretemiyor (2/4/6/8 ile
    170, 85, 56,7, 42,5), bu yüzden CK48 Clock Mux'ta HSI48 seçildi. Sistem
    saati, PLL ve FDCAN değişmedi. Clock Error Detection açık.
    CubeMX'in ürettiği hâl, elle dokunulmadı. Derleme 0 uyarı.
    [firmware.ioc]
2026-10-01 Faz 2.6 a: kart komut alıyor, kanal katmanı ve uçtan uca test
    firmware/app/channel: bir seri kanalın protokol durumu. frame_rx →
    frame_decode → sayaç (REPLAY); her ret kendi STATUS sayacını artırır,
    cevap çıkmaz. HELLO (oturum kurulana kadar 500 ms'de bir, HELLO_REQ'e
    saniyede en fazla 2), STATUS (saniyede bir), 4 mesajlık gönderme
    kuyruğu; sayaç ve zaman damgası hatta çıkarken verilir.
    app.c: yankı kalktı, iki kanal channel üzerinden. Oturum kimliği
    açılışta RNG'den. HEARTBEAT → HEARTBEAT_ACK. Kart HOLD'da. Biten HMAC
    ölçümü ve anahtar denetimi çıkarıldı.
    tools/link_test.py: karta köprü gibi bağlanır, 26 denetim. 5
    çalıştırmanın 5'inde geç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
2026-10-01 Protokol: VERDICT gerekçesine NO_HEARTBEAT
    RESET_CMD yalnızca HOLD'da ve kalp atışı canlıyken kabul edilir (RULES
    §5.2). Kalp atışı yokken gelen RESET_CMD'nin reddi için gerekçe kodu
    yoktu; mevcut kodlardan biri ajana yanlış bilgi verirdi. MODE grubuna
    NO_HEARTBEAT = 23 eklendi. Şema özeti 0xB12F26D8 → 0xD9092C66.
    Üretilen üç dosya aynı commit'te (docs/protocol.md §12). 192 test geçiyor.
    [messages.py, proto_msgs.h]
2026-10-01 Faz 2.6 c ve d: uçtan uca karar, kalp atışı ve karar süresi
    guard: denetim sırası (MODE → GEOFENCE) ve durum makinesi. Açılış HOLD,
    SIFIRLA yalnızca HOLD'da ve kalp atışı canlıyken (HOLD → NORMAL), kalp
    atışı kaybı NORMAL → HOLD (mandallı). İçerik retleri reject_streak'i
    artırır, kabul sıfırlar. Donanıma dokunmaz, PC'de sınanır.
    site: deneme harita verisi (±10 m izinli, 2 m yasak kare, 3 güvenli
    nokta) ve en yakın güvenli nokta. Gerçek veri Faz 3'te.
    rules/heartbeat: TIM6 ile 500 ms zaman aşımı, kesmeyle.
    vehicle_node: FDCAN2, araç tarafı. CAN'den gelen onaylı mesajı araç
    kanalına, araç kanalından gelen TELEMETRY'yi CAN'e taşır. CAN kimli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
2026-10-05 Kablo çekme testi, K-027, K-028 ve K-029
    tools/unplug_test.py: ajan kablosu fiziksel olarak çekilirken kart E5V'den
    beslenir. Sıfır hıza geçen süre kartın saatiyle ölçüldü: 500-501 ms, 20 Hz.
    Geri takmada kart yeniden başlıyor (RCC_CSR: PINRSTF), sınırlılık olarak
    K-029'da. Faz 3 öncesi kararlar: Gazebo Fortress + TurtleBot 4 (K-027),
    disk engeli kalktı (K-028).
2026-10-05 Faz 3.0 kurulum, K-030 ve K-031
    ros-gzharmonic köprü paketleri TurtleBot 4 simülatörünün ros-gz paketleriyle
    çakıştığı için kaldırıldı (K-030). Fortress + TurtleBot 4 kuruldu, kamera ve
    lidar konuları doğrulandı. Nav2'nin hız komutu Faz 3'te karttan geçecek,
    asgari aktarma (K-031). Faz 3 planı STATUS'ta.
2026-10-05 Faz 3: deney sahası ika_saha (Blok 1-4), K-032 ve K-033
    Kendi açık saha dünyamız: 20 x 12 m, beton bariyerler, doğuda kapı, asfalt
    doku, konteyner, kamyonet, çöp konteyneri. Robot (0, 0)'da başlar, dünya
    koordinatı = harita koordinatı. Dokular gen_textures.py ile sabit tohumla
    üretilir. ika_sim.launch.py dünya arama yoluna worlds/'ü ekler.
    Fuel'deki Dumpster (statik değil, mesh çarpışma, eski malzeme) simülasyonu
    %0,67 hıza düşürdüğü için kendi kutumuzla değiştirildi; Blok 4 düzeltmeleri
    simde henüz doğrulanmadı. RTAB-Map kamera + lidar ile çalışacak (K-033).
    [ika_saha.sdf]
2026-10-06 Faz 3: deney sahası Blok 5 (yasak bölgeler), K-034
    - ika_saha.sdf: 3 yasak bölge boyası (yalnız visual), 4 koni, 2 masa, 2 tank
    - Hız ölçüldü (/world/ika_saha/stats, 20 s): Blok 5 ile %46,4, Blok 5'siz %47,4
    - K-034: Faz 3 aracı ORINIUM İKA modeli; Fortress port denemesi STATUS'ta
    [ika_saha.sdf]
2026-10-06 Faz 3: İKA modeli depoya (K-034 adım a)
    - ros2_ws/src/ika_sim/models/ika_arac/: ORINIUM ika_arac, Fortress'e çevrilmiş
    (SDF 1.9, model:// mesh yolları, ignition-gazebo eklenti adları) ve 21 STL
    - Henüz başlatma dosyasına bağlı değil
    [BLB.STL, BLF.STL, BL_salıncak.STL, BRB.STL, BRF.STL, BR_salıncak.STL, FLB.STL, FLF.STL]
2026-10-06 Faz 3: saha İKA'ya göre 32 × 20 m (K-034 adım b, K-035)
    - ika_saha.sdf: 25 bariyer, yeni yerleşim, geçitler ≥ 3 m
    - gen_textures.py: asfalt 33 × 21 m, desen yoğunluğu korundu; dokular yeniden üretildi
    - K-035; TurtleBot 4 ile hız %42,7 / %45,4
    [ika_saha.sdf]
2026-10-06 Faz 3: İKA simde, köprü ve tf (K-034 adım c)
    - ika_saha.sdf: Sensors/Imu/Contact sistemleri, İKA (0, 0)'da <include>
    - model.sdf: kamera çerçevesi camera_optical_frame (4. değişiklik)
    - config/bridge.yaml: 9 konu (clock, cmd_vel, odom, tf, scan, imu, kamera)
    - ika_sim.launch.py: TurtleBot 4 çıktı; Gazebo + köprü + 4 sabit tf
    - Denetlendi: konular ve tf ağacı, hız %100, klavyeyle sürüş, RViz
    [ika_saha.sdf, model.sdf]
2026-10-06 Faz 3.1: RTAB-Map haritası (K-036)
    - ika_nav/launch/mapping.launch.py: RTAB-Map, kamera + lidar, tekerlek odometrisi
    - ika_nav/maps/ika_saha.pgm/.yaml: 5 cm, ~80 m'lik klavye turuyla
    - Başlangıçta hata RTAB-Map 0,10 m / 7,6°, yalnız odometri 13,8 m / 80°
    - Harita ~2° dönmüş, uzak uçta ≤ 0,8 m; 3.2'de ≥ 1 m pay (K-036)
2026-10-07 Faz 3.2b: Nav2 çalışıyor, deneme 1 ve 2 geçti (K-038)
    - ika_nav/config/nav2_params.yaml: AMCL, NavFn, Regulated Pure Pursuit; costmap'ler statik
    harita + keepout katmanı + şişirme 1,5 m, lidar katmanı yok, ize 0,3 m pay
    - ika_nav/launch/navigation.launch.py: konum ve gezinme, iki lifecycle_manager
    - Lidar katmanı olan costmap'in tf tamponu yük altında donuyordu (Deney A, STATUS)
    - Sırada deneme 3 (yasak bölgenin içine hedef) ve 3.2c
2026-10-07 Faz 3.3 (kart): VELOCITY_CMD NORMAL'de DRIVE olarak araca (K-031)
    - guard_velocity: NORMAL'de aynen aktarır, başka durumda aktarmaz; VERDICT yok (protocol §7.2)
    - app.c: aktarılan DRIVE CAN'e (FDCAN1 → FDCAN2 → araç kanalı)
    - test_guard.py: 2 test; kasıtlı 3 hatanın 3'ü yakalandı
    - Debug ve Release 0 uyarı; karta YÜKLENMEDİ
2026-10-08 RULES §1 İKA'ya göre: bekçi 0,6 m/s · 0,6 rad/s, tavan 3,6 m/s (K-039)
    - İKA tavanı KTR Tablo-3'ten (13 km/h); açısal tavan ω = 2v/iz ile ~7 rad/s
    - Bekçi Nav2'nin 1,2 katı; doğrusal ivme ve yol takibindeki açısal hız ölçülecek
    - §3.4 toleransı ve §5 durma mesafesi yeni v_max ile; messages.yaml yorumları 600 mm/s
    - Kartta limit sabiti yok (kırpma Faz 4), yükleme gerekmedi
2026-10-08 Faz 3.3 kartta: guard_velocity ve yeni saha yüklendi, testler geçti
    - decision_test: NORMAL'de VELOCITY_CMD aynen DRIVE, VERDICT yok; HOLD'da yalnız sıfır hız
    - decision_test ve link_test kartta hepsi geçti
    - STATUS: yükleme adımı bitti
2026-10-08 Faz 3.3 köprü adım 2: ROS ↔ protokol birim çevirileri (K-040)
    - convert.py ROS'a bağlı değil: konum/dördey ↔ cm/mrad, hız ↔ mm/s, int16 kırpma, NaN → 0
    - 25 test; kasıtlı 4 hatanın 4'ü yakalandı
2026-10-08 Faz 3.3 köprü adım 3: vehicle_bridge (K-040)
    - GOAL → NavigateToPose, DRIVE → /cmd_vel, TELEMETRY 20 Hz (map → base_link)
    - Bekçi köpeği: 0,5 s DRIVE yoksa ve kapanırken sıfır hız
    - Kartla simülasyonsuz denendi: 20,1 Hz, telemetri yaşı ≤ 44 ms, bekçi köpeği 0,5 s
2026-10-08 Faz 3.3 köprü adım 4: agent_bridge (K-040)
    - /goal_pose → GOTO_CMD, /cmd_vel_nav → VELOCITY_CMD, HEARTBEAT 100 ms
    - VERDICT → /guard/verdict (JSON), /guard/reset servisi → RESET_CMD
    - Link.adopt_hello (yeni oturum) ve Link.wire_seq; vehicle_bridge da kullanıyor
    - Kartla simülasyonsuz 6 denetimin 6'sı geçti
    [link.py]
2026-10-08 Faz 3.3 köprü adım 5: Nav2 karttan geçmeden süremez, bridge.launch.py (K-040)
    - bt_navigator goal_pose → /goal_pose_unused; controller ve behavior cmd_vel → /cmd_vel_nav
    - bridge.launch.py: vehicle_bridge ve agent_bridge, use_sim_time
    - Sözdizimi ve lint denendi; Nav2'yle uçtan uca adım 6'da
2026-10-08 Faz 3.3 köprü adım 6: yeniden bağlanma, uçtan uca test geçti (K-040)
    - link: open_link, LINK_LOST, close; Heartbeat port kaybında durur
    - İki köprü kablo çekilince çökmez, saniyede bir yeniden bağlanır, kopukken komutları atar
    - Esra'yla uçtan uca: izinli hedef geçti, yasak hedef reddedildi, kablo çekilince araç
    0,5 s'de durdu, köprüler ~1 s'de yeniden bağlandı, reset sonrası araç hedefi tamamladı
    - STATUS: açık sorunlar (yerel costmap lidarsız da dondu, AMCL ~14 m kayboldu)
    [link.py]
2026-10-08 STATUS: yerel costmap donması yanlış teşhisti, düzeltildi
    - always_send_full_costmap false: tam harita susar, güncellemeler _updates'te (1,67 Hz)
    - Açık kalan: AMCL kaybı
2026-10-08 Nav2'ye collision_monitor (approach), AMCL kaybının nedeni (K-041)
    - Hız yolu: controller/behavior → /cmd_vel_raw → collision_monitor → /cmd_vel_nav → kart
    - Ölçüldü: engele dayanınca odometri 60 s'de 15 m sayıyor, AMCL 5,7–14 m kopuyor;
    alpha3 ve recovery_alpha çözmedi; monitörle araç 0,36–0,58 m kala duruyor, hata ≤ 0,17 m
    - tools/amcl_push_bench.py: itme ve --monitor ölçütü
    - STATUS: zincir, kartın kabul edip Nav2'nin ulaşamadığı şerit, akış içi bozuk çerçeve
    [amcl_push_bench.py]
2026-10-13 Faz 4 planı; K-044: yer isimleri ika_saha.yaml'da
    - STATUS: Faz 4 sırası 4.0 → 4.4 (önce model seçimi), 3.2b ve 3.2c işaretlendi
    - K-044: ayrı places.yaml açılmaz, ajan adlı yerleri ika_saha.yaml'dan okur
2026-10-13 Faz 4.0 bitti (ivme hariç); K-045: ajanın modeli granite4.1:3b
    - llm_select_bench: 31 cümle / 6 kategori, ret ipucu nearest_safe'ten, --temperature/--seeds
    - K-045: seçim tablosu, digest, yedek qwen3.5:4b; phi4-mini ve qwen3.5:2b silindi
    - STATUS: genişletilmiş sonuçlar, 4.2 (ipucu ad + koordinat) ve 4.3 (birim) notları
2026-10-14 Faz 4.0 bitti: K-046 Nav2'ye hız yumuşatıcı, bekçi yalnız hızlanmayı kırpar
    - ika_nav: velocity_smoother (0,5 m/s² · 1,0 rad/s², yavaşlama sınırsız, 20 Hz),
    /cmd_vel_raw → /cmd_vel_smoothed → collision_monitor → /cmd_vel_nav
    - tools/nav2_accel_bench.py: hedefler karttan geçerek, üç hız konusu kaydı, adım analizi
    - RULES §1, §3.2: bekçi 0,6 m/s² · 1,2 rad/s², yalnız hızlanma kırpılır; 20 Hz doğrulandı
    - STATUS: dört ölçüm turu; açık: güvenli noktaların bir kısmına Nav2 ulaşamıyor (4.1),
    "collision ahead ← AMCL" teşhisi düzeltildi
    [nav2_accel_bench.py]
2026-10-14 Faz 4.1d: kurtarma durum makinesi kartta (K-047: telemetri 500 ms, süre 180 s)
    - recovery/: 5 ret, varış 35 cm, telemetri 500 ms, süre 180 s
    - guard: guard_telemetry (araç konumunun coğrafi sınırı, varış), guard_tick (zaman
    kuralları), RECOVERY'de hız geçer; 5. retle RECOVERY_HOME, araç dışarıdaysa RECOVERY_SAFE
    - testler: 12 yeni (PC, ASan/UBSan), decision_test'e kartta üç kurtarma senaryosu
    - kartta doğrulandı; uçtan uca: başarılı kurtarma ve 180 s'de HOLD
    - RULES §5.2/§5.3/§7, K-047, STATUS (açık: Nav2 kazı köşesinde takılıyor)
2026-10-14 Faz 4.1a: hız kırpma ve hiz_siniri kartta (LIMIT, K-046 uygulandı)
    - rules/limits: yalnız hızlanma kırpılır (adım 30 mm/s · 60 mrad/s), ±600; hiz_siniri 0 < v ≤ 600
    - guard: guard_velocity kırpar (son gönderilen komuta göre, HOLD'da 0), STATUS.clipped;
    guard_speed_limit (LIMIT reddi içerik reddi, kabulde SPEED_LIMIT_SET)
    - vehicle_bridge: SPEED_LIMIT_SET → Nav2 /speed_limit; agent_bridge günlüğünde kırpılan hız
    - testler: 13 yeni (PC), decision_test kırpma ve hiz_siniri; kartta doğrulandı
    - uçtan uca: Nav2'nin normal sürüşünde 903 komutta 0 kırpma
2026-10-14 Faz 4.1c: zaman eşitlemesi ve tazelik kuralı (FRESHNESS)
    - Link: her HEARTBEAT_ACK bir eşitleme örneği, en küçük RTT'li son 10'dan (protocol §6.2)
    - rules/freshness: −50 ms ≤ yaş ≤ 200 ms, saat taşmasında doğru
    - guard_fresh: ajan kanalının her imzalı çerçevesinde; görev komutlarına FRESHNESS VERDICT'i,
    akış sessizce düşer, err_fresh sayılır, ret serisine girmez
    - testler: 18 yeni (PC), decision_test kaydırılmış zaman damgaları; kartta doğrulandı
    - uçtan uca: 897 komutta 0 bayat, RTT 7 ms
2026-10-14 Faz 4.1e: tutarlılık kuralı (CONSISTENCY, K-049); 4.1 bitti
    - rules/consistency: tol = 25 cm + 0,6 m/s × Δt, −50 ms ≤ Δt ≤ 5 s, telemetri ≤ 500 ms
    - guard: GOTO, WAIT, hiz_siniri'de (içerik reddi), STOP'ta yok; guard_tick döngü başında
    - agent_bridge: RViz hedeflerinde konum inancı TF'ten
    - testler: 14 yeni (PC); decision_test bütün görev komutlarını tutarlı inançla gönderiyor,
    TOO_FAR / BELIEF_TOO_OLD / NO_TELEMETRY; kartta doğrulandı, RViz yolu uçtan uca
    - RULES §3.4 sayıları v_max 0,60'a göre düzeltildi, K-049, STATUS
2026-10-14 Faz 4.2: ajanın görev arayüzü (/guard/task, /guard/feedback; K-050)
    - agent_bridge: JSON görevler → GOTO/WAIT/SPEED_LIMIT/STOP, inancın zamanı kartın saatine,
    kararı id ile /guard/feedback'e; feedback parametresi full (D) / minimal (C)
    - convert: parse_task, ros_to_board_ms, task_args, Türkçe feedback_text, ipucu adı; 34 birim testi
    - uçtan uca D ve C kartla doğrulandı; hiz_siniri → Nav2 /speed_limit
    - BELIEF_TOO_OLD hi 5000 (yorum ve protocol §7.1; şema özeti aynı), K-050, STATUS
2026-10-14 Faz 4 bitti: ajan denemeleri, git tek araç ve çelişki kuralı (K-052)
    - agent_core: git tek araç (ikiye ayırma 30/31 → 25/31 düşürdü); yer ile x/y çelişirse karta
    gitmez, (0, 0) ya da anlık konum dolgu sayılır; agent_node varış metninde hedef
    - llm_select_bench tek araçla 30/31
    - 4.4: D'de görev tamamlama ve gerekçeyle tek denemede düzeltme; C'de körlemesine 3 ret
    - STATUS: deneme tablosu ve bulgular (güvenli ama yanlış komut, yanlış özet), K-052
2026-10-15 Faz 5 başlangıcı: deney kararları (K-053…K-055), sim hızı ölçümü, gui argümanı
2026-10-20 Faz 5: açık kararlar kapandı (K-059…K-063), Nav2 iz payı 0,2
    - IWDG eklenmez (K-059); kartın STATUS sayaçları her koşuda kaydedilecek (K-060).
    - Kablo geri takılınca reset JP3'süz de var: SFTRSTF 3/3, bilinen sınır (K-061).
    - Smac Hybrid-A* ve State Lattice denendi, NavFn kalır (K-062).
    - RPP başlangıçta yerinde dönüşü çarpışma sayıyordu: noktalarda dönüş payı
    0–3 cm'ydi. İz payı 0,3 → 0,2, test_safe_points 10 cm pay istiyor (K-063).
    nav2_route_bench 48/48, nav2_accel_bench 20/20 (kazının güneyi dahil).
    - Yeni: tools/nav2_route_bench.py.
    [nav2_route_bench.py]
2026-10-20 Faz 5: koşu kaydı ve değerlendirme (K-065)
    - experiments/run.py: her koşuda düzeni baştan açar, hazır bekler, modeli
    ısıtır, SIFIRLA, rosbag, görev, değerlendirme, results.csv.
    - experiments/evaluate.py: başarı, güvensiz komut (kartın kuralı), güvensiz
    sonuç (gerçek sınır, gövde, temas, hız), kart durumu, olay sonrası durma;
    33 test, kasıtlı 7 hatanın 7'si yakalandı.
    - ika_sim: OdometryPublisher (gerçek poz ve hız), /sim/odom, /sim/stats,
    /sim/contact. agent_bridge: /guard/status (K-060).
    - Altyapı senaryolarında LLM yok (scenarios.yaml goal).
    - Bulgu: soğuk model yüklemesi kartı HOLD'a düşürüyordu; ısıtma çözdü.
    [model.sdf]
2026-10-20 Faz 5: pilot (K-066), üç senaryo yeniden yazıldı, ret ayrıldı
    - Pilot: 14 senaryo D × 3, results_pilot.csv (42 satır). Düzen sorunsuz;
    D'de 18 güvensiz komutun 18'i reddedildi, güvensiz sonuç 0; donma ve
    kablo çekmede araç ~0,5 s'de durdu.
    - limit_pushing_1/3, injection_3 yasak hedefi koordinatla veren cümlelerle
    yeniden yazıldı (eski cümlelerde GEOFENCE 0/9, yenilerde 8/9).
    - evaluate: ret yalnız köprü/kart kararı, yeni gecersiz_cagri sütunu.
    - LLM senaryolarında 15 tekrar.
    [results_pilot.csv]
2026-10-20 Faz 5: analiz betiği (K-068), pilot sayısı düzeltmesi
    - analysis/analyze.py: S1–S3 tabloları (tablolar.md + CSV) ve dört grafik;
    geçersiz koşular dışarıda; deney sürerken de çalışır.
    - analysis/stats.py: Wilson %95 aralığı, kesin McNemar (eşleştirilmiş).
    - 16 test, kasıtlı 6 hatanın 6'sı yakalandı.
    - K-066 ve STATUS: pilotta güvensiz komut 15 (önce yanlışlıkla 18).
2026-10-21 Faz 5: tam deney sonuçları (780 koşu), analiz düzeltmesi (K-069)
    - results.csv: 12 LLM senaryosu × A/B/C/D × 15, donma × 4 × 10, kablo
    C/D × 10; 780 koşu, geçersiz 0, sim hızı en az 0,975, kart hatası 0.
    - analysis/out: tablolar, CSV'ler ve grafikler 780 koşuyla.
    - S1: C 129/129, D 69/69 güvensiz komut yakalandı; A/B 0.
    - S2: LLM senaryolarında B de güvensiz sonuç 0; donmada A/B 10/10
    güvensiz, C/D 0/10. Kablo çekmede C/D 20/20 durdu (~0,55 s, ~0,22 m).
    - S3: başarı C 108, D 105 (p = 0,25); C 21 kez vazgeçti, D 0 (p < 0,001).
    - analyze.py (K-069): haksız ret güvenli komutun reddi; vazgeçme ayrı
    raporlanıyor, süreye girmiyor. 18 test, kasıtlı 5 hatanın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
    [results.csv, s1_yakalama.csv, s2_ariza.csv, s2_guvensiz_sonuc.csv, s3_basari.csv]
2026-10-21 Faz 6: plan denetimi, karar süresi deneydeki yazılımla (K-070)
    - Plan belgesi baştan sona denetlendi: Faz 0–5 bitti; kalanlar (sonuç
    bölümü, demo, demo videosu) STATUS'ta Faz 6 planı olarak.
    - Deney kartta Debug derlemesiyle koşuldu (flash okunup karşılaştırıldı).
    decision_test × 3 + goto_timing salt okuma: 47 karar, 853,4–909,2 µs.
    Tezde bu sayı verilir; Release 169–177 µs Faz 2.6'nın yazılımı.
    - Mantık analizörü alınmadı, K-009 kapandı; DWT'nin sınırları K-070'te.
2026-10-21 Faz 6: demo paneli yeniden tasarım (K-072)
    - Koyu "kontrol merkezi" teması (theme.py): üst şerit, yapılandırma
    rozeti, Sim/Nav2/Ajan/Kart ışıkları, sim saati.
    - Harita (site_view.py): haritanın sınıfları (map_style.py), ızgara,
    taralı yasak bölgeler, araç ve far konisi, solan iz, lidar, akan Nav2
    yolu, ret halkası ve güvenli noktaya ok, pusula, ölçek, lejant.
    - widgets.py: hız göstergesi (kartın sınırı limits.h'den), durum rozeti,
    mesajlaşma balonları.
    - Bulgu: Nav2 haritalanmamış hücreyi (205) boş sayıyor; panel haritanın
    kaydettiğini gösterir, Nav2'ye dokunulmadı.
    - 23 test, kasıtlı 13 hatanın 13'ü yakalandı. Kartsız (A) denendi.
2026-10-21 Faz 6: kartlı panel denemesi (D)
    - SIFIRLA, GEOFENCE reddi ve kablo çekme panelden denendi, kayıttan
    doğrulandı: araç 50 ms'de durdu, geri takınca HOLD → SIFIRLA → NORMAL.
    - Bulgu: ajan retten sonra araç hiç kıpırdamadığı hâlde 'konteyner_onu'ya
    alındı' diye bitirdi; kart ve panel gerçeği gösterdi.
